IL2232-HT2022-HIL/HARDWARE_DEV/README.md

# HARDWARE_DEV
Hardware development for the project
