IL2232-HT2022-HIL/HARDWARE_DEV/ADAPTER_BOARD/GERBERS/V1/JLCPCB/BOM_V1.csv

Comment | Designator | Footprint | LCSC Part Number
100nF 25V | C1 C2 | C_0603_1608Metric | C14663
1kR | R1 R2 R3 R4 R5 R6 R7 R8 R9 R10 R11 R12 R13 | R_0603_1608Metric | C21190
10kR | R14 R15 | R_0603_1608Metric | C25804
120R | R21 R22 | R_0603_1608Metric | C22787
3k3 | R16 | R_0603_1608Metric | C22978
general-purpose | D1 D2 | D_SOD-323 | C60580
SN65HVD233 | U1 U2 | SOIC-8_3.9x4.9mm_P1.27mm | C61643
