IL2232-HT2022-HIL/HARDWARE_DEV/ADAPTER_BOARD/SCHEMATICS/HIL_ADAPTER_BOARD_V1.pdf

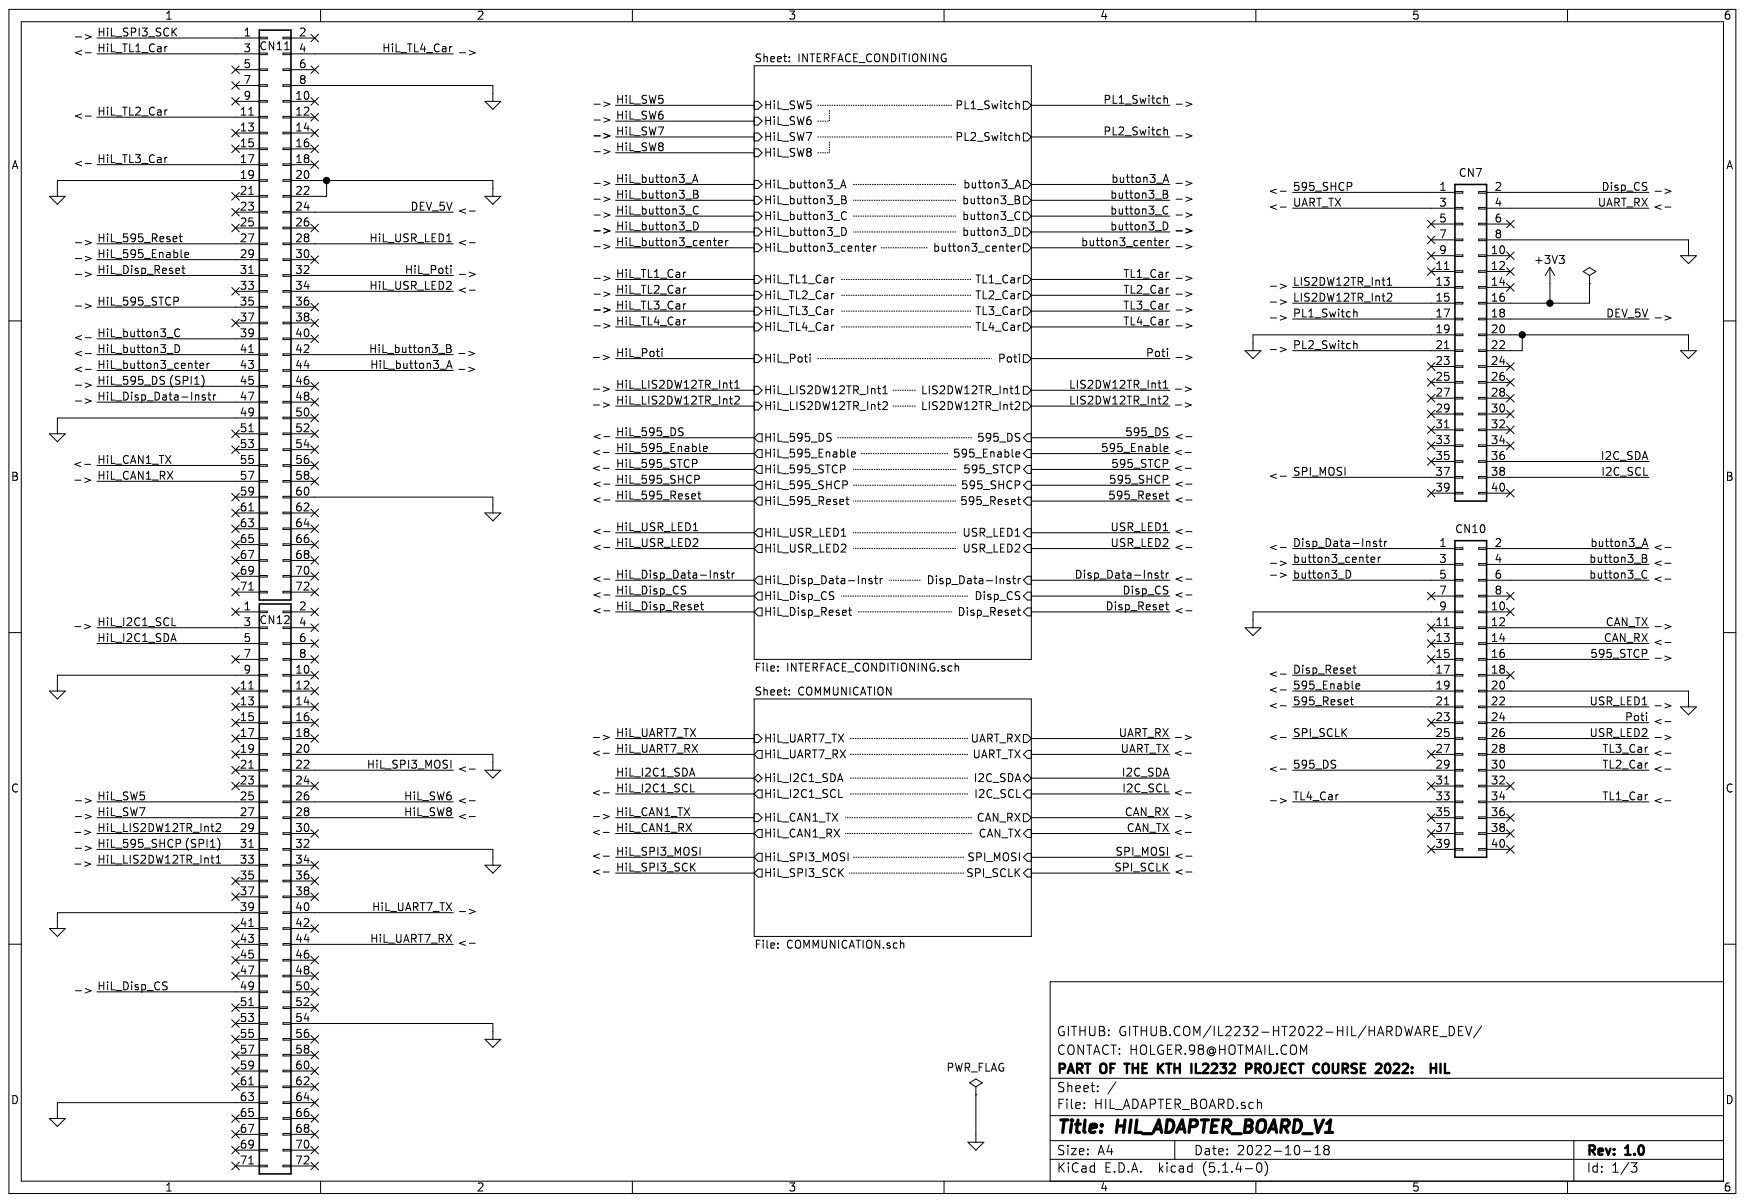
[picture p1: page 1]

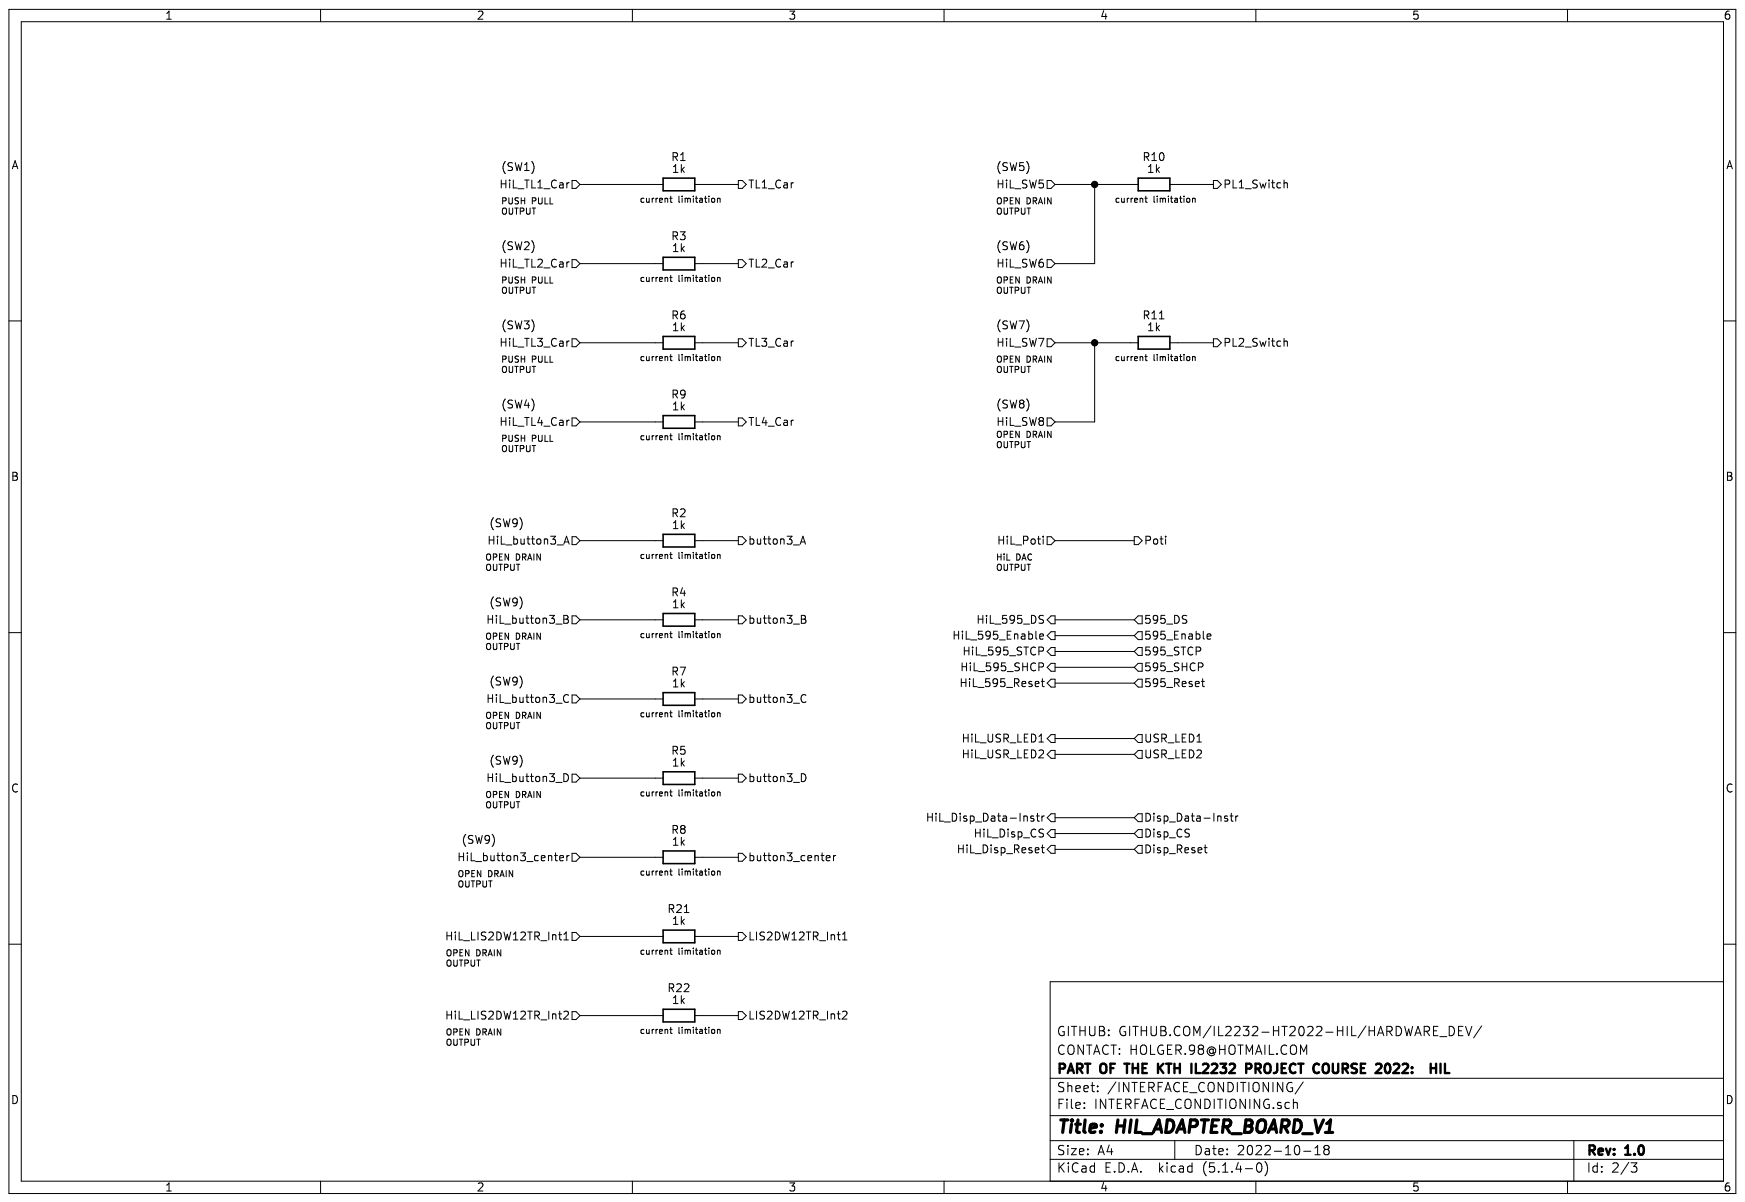
[picture p2: page 2]

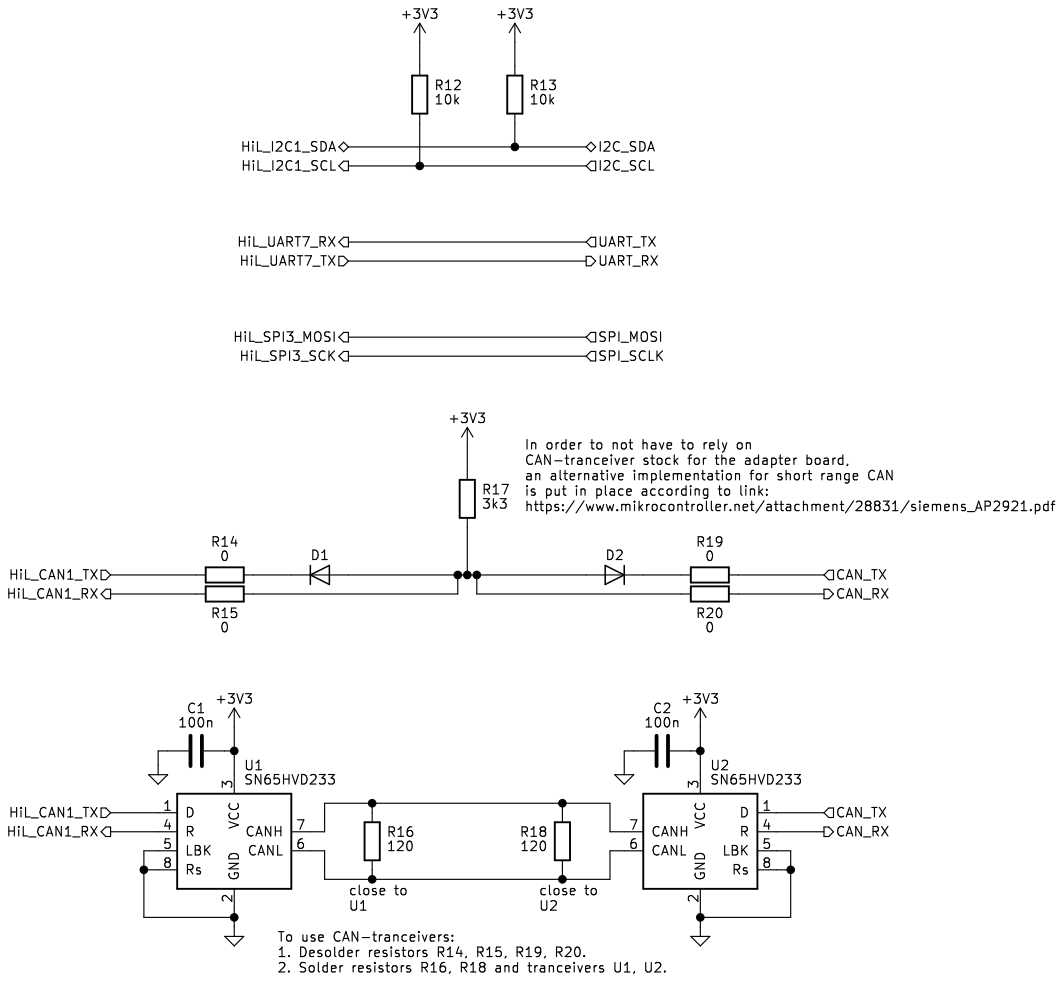
[picture p3: page 3]
