IL2232-HT2022-HIL/HARDWARE_DEV/ADAPTER_BOARD/HIL_ADAPTER_BOARD_V1/HIL_ADAPTER_BOARD.kicad_pcb

## KiCad design ADAPTER_BOARD/HIL_ADAPTER_BOARD_V1/HIL_ADAPTER_BOARD.kicad_pcb (2022-11-03)

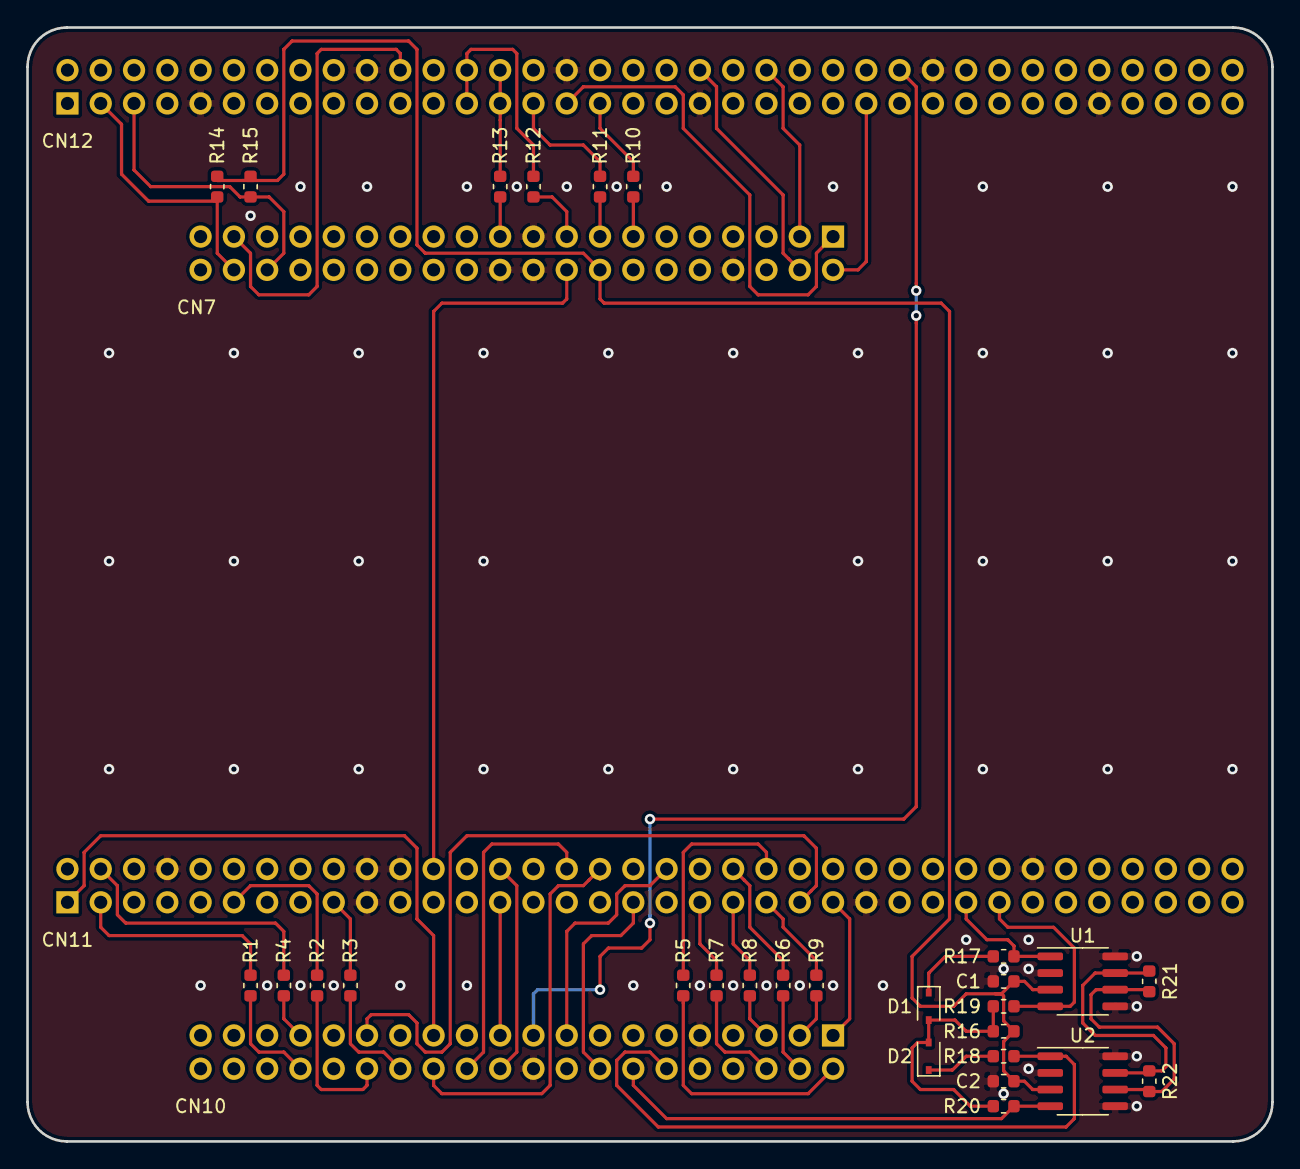
[picture p4: board HIL_ADAPTER_BOARD.kicad_pcb from above]

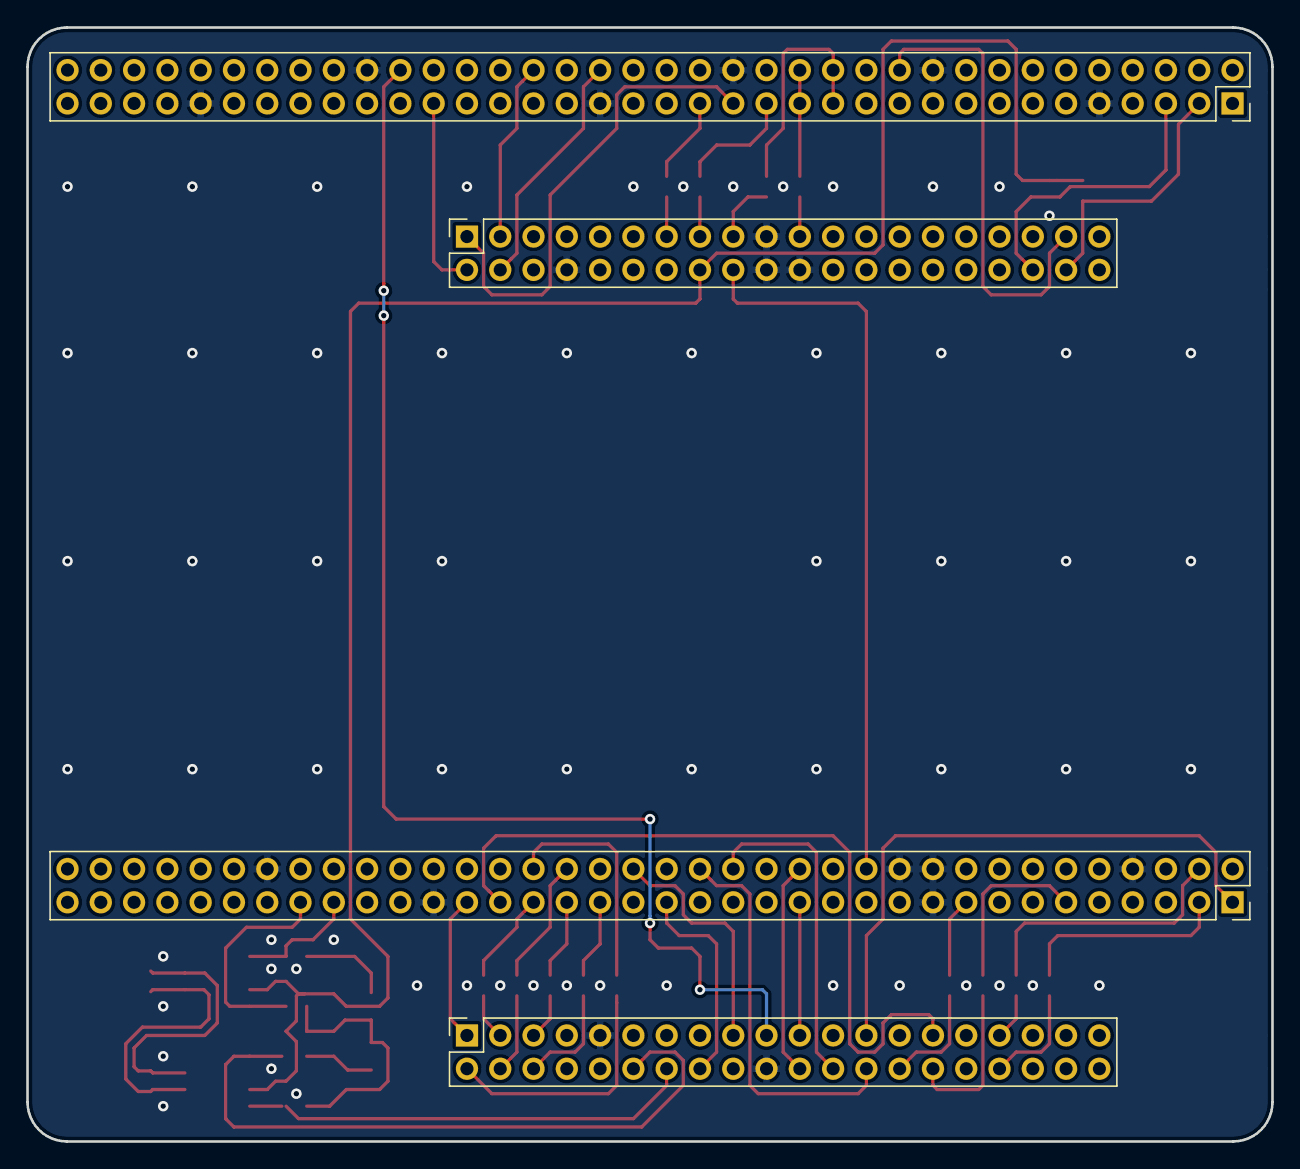
[picture p5: board HIL_ADAPTER_BOARD.kicad_pcb from below]

Board: 2 copper layers, 95.0 x 85.0 mm, 32 parts (4 on the bottom side), 55 nets.

Parts:
C1, C2: 100n; C_0603_1608Metric
CN7, CN10: Conn_02x20_Odd_Even; PinSocket_2x20_P2.54mm_Vertical
CN11, CN12: Conn_02x36_Odd_Even; PinSocket_2x36_P2.54mm_Vertical
D1, D2: D; D_SOD-323
R1, R2, R3, R4, R5, R6, R7, R8, R9, R10, R11, R12, R13: 1k; R_0603_1608Metric
R14, R15: 10k; R_0603_1608Metric
R16: 3k3; R_0603_1608Metric
R17, R18, R19, R20: 0; R_0603_1608Metric
R21, R22: 120; R_0603_1608Metric
U1, U2: SN65HVD233; SOIC-8_3.9x4.9mm_P1.27mm

Connections:
+3V3: C1.1, C2.1, CN7.16, R14.1, R15.1, R16.1, U1.3, U2.3
/595_DS: CN10.29, CN11.45
/595_Enable: CN10.19, CN12.52
/595_Reset: CN10.21, CN11.27
/595_SHCP: CN7.1, CN12.31
/595_STCP: CN10.16, CN11.35
/CAN_RX: CN10.14, R20.1, U2.4
/CAN_TX: CN10.12, R18.1, U2.1
/DEV_5V: CN7.18, CN11.24
/Disp_CS: CN7.2, CN12.49
/Disp_Data-Instr: CN10.1, CN11.47
/Disp_Reset: CN10.17, CN11.38
/HiL_CAN1_RX: CN11.57, R19.2, U1.4
/HiL_CAN1_TX: CN11.55, R17.2, U1.1
/HiL_I2C1_SCL: CN7.38, CN12.3, R14.2
/HiL_I2C1_SDA: CN7.36, CN12.5, R15.2
/HiL_LIS2DW12TR_Int1: CN12.33, R10.2
/HiL_LIS2DW12TR_Int2: CN12.29, R11.2
/HiL_Poti: CN10.24, CN11.32
/HiL_SPI3_MOSI: CN7.37, CN12.22
/HiL_SPI3_SCK: CN10.25, CN11.1
/HiL_SW5: CN12.25, CN12.26, R12.2
/HiL_SW7: CN12.27, CN12.28, R13.2
/HiL_TL1_Car: CN11.3, R1.2
/HiL_TL2_Car: CN11.11, R2.2
/HiL_TL3_Car: CN11.17, R3.2
/HiL_TL4_Car: CN11.4, R4.2
/HiL_UART7_RX: CN7.3, CN12.44
/HiL_UART7_TX: CN7.4, CN12.40
/HiL_USR_LED1: CN10.22, CN11.28
/HiL_USR_LED2: CN10.26, CN11.34
/HiL_button3_A: CN11.44, R5.2
/HiL_button3_B: CN11.42, R6.2
/HiL_button3_C: CN11.39, R7.2
/HiL_button3_D: CN11.41, R8.2
/HiL_button3_center: CN11.43, R9.2
/LIS2DW12TR_Int1: CN7.13, R10.1
/LIS2DW12TR_Int2: CN7.15, R11.1
/PL1_Switch: CN7.17, R12.1
/PL2_Switch: CN7.21, R13.1
/TL1_Car: CN10.34, R1.1
/TL2_Car: CN10.30, R2.1
/TL3_Car: CN10.28, R3.1
/TL4_Car: CN10.33, R4.1
/button3_A: CN10.2, R5.1
/button3_B: CN10.4, R6.1
/button3_C: CN10.6, R7.1
/button3_D: CN10.5, R8.1
/button3_center: CN10.3, R9.1
GND: C1.2, C2.2, CN7.8, CN7.19, CN7.20, CN7.22, CN10.9, CN10.20, CN11.8, CN11.19, CN11.20, CN11.22, CN11.49, CN11.60, CN12.9, CN12.20, CN12.32, CN12.39, CN12.54, CN12.63, U1.2, U1.5, U1.8, U2.2, U2.5, U2.8
unnamed: D1.1, R17.1
unnamed: D1.2, D2.2, R16.2, R19.1, R20.2
unnamed: D2.1, R18.2
unnamed: R21.1, R22.1, U1.7, U2.7
unnamed: R21.2, R22.2, U1.6, U2.6
