IL2232-HT2022-HIL/HARDWARE_DEV/(threads)

Thread 1 (2022-09-15):

Setup Kicad with the HARDWARE_DEV repo

HolgerStenberg, 2022-09-15:
I think that Kicad should be used as the ECAD tool for developing the adapter PCB described in the project proposal.
I will therefore setup a kicad 5.0 project in this repo

HolgerStenberg, 2022-09-15:
I think that Kicad should be used as the ECAD tool for developing the adapter PCB described in the project proposal.
I will therefore setup a kicad 5.0 project in this repo

Closed 2022-09-16.

Thread 3 (2022-09-15):

Aquire and familiarize with hardware boards

HolgerStenberg, 2022-09-15:
Find out about, install development environment.

HolgerStenberg, 2022-09-15:
There are two boards that will be part of the project:
- The MCU Development Board: Nucleo-L476RG
- The MCU HiL Board : Nucleo-F767ZI

I will investigate if these boards can be found as CAD-files

HolgerStenberg, 2022-09-16:
Additional information from mattias regarding what signals that are of interest is required to continue

HolgerStenberg, 2022-09-19:
MII or RMII ehternet interface?
- [ ] Solved?

sofiecmf, 2022-09-19:
We need for sure that these peripherals exists and do not collide with anything else :

1 USART bus
1 I2C bus
1 SPI bus
Ethernet (RMII or MII)
DAC for HiL (for potentiometer emulator)
ADC for Development MCU (for potentiometer read)

HolgerStenberg, 2022-09-19:
We are thinking of combining the power from both pcbs with only one usb cable (for ease-of-use).
Currently looking into how to configure the boards such that the MCU Development Board can power the adapter board and the HiL Board

HolgerStenberg, 2022-09-19:
On small board:
dis-connect JP1 for 300 mA over ST-link

Closed 2022-09-27.

Thread 4 (2022-09-15):

Work out the requirements for adapter PCB

HolgerStenberg, 2022-09-15:

HolgerStenberg, 2022-09-19:
We need for sure that:
* One usart bus needed
* 1 I2C BUS
* SPI BUS

HolgerStenberg, 2022-09-20:
We have gotten the schematic for the I/O board that we need to emulate

[Schematic_IS1300_2022_2022-04-19.pdf](https://github.com/IL2232-HT2022-HIL/HARDWARE_DEV/files/9607655/Schematic_IS1300_2022_2022-04-19.pdf)

HolgerStenberg, 2022-09-30:
Too broad issue for sprint. Is now divided into smaller sub-tasks in sprint 2

Closed 2022-10-18.

Thread 6 (2022-09-22):

Source and solder on X3 crystal oscillator on HiL-board

olleblo, 2022-09-22:
First investigate if HSI oscillator (16 MHZ ) on  board is enough and is usable.
In order to get intra-IC connectivity for ethernet communication to work properly and reliably, Holger states that we need to solder on a missing crystal oscillator (X3 on the PCB). See picture below for placement.

DONE CRITERIAS:
- [ ] When the correct crystal is soldered on.
- [ ] Jumper SB148 and SB163 OFF (Underside)
- [ ] SB8 and SB9 soldered
- [ ] C37 and C38 soldered with 4.3 pF capacitors. Footprint: 0603
- [ ] SB112 and SB149 OFF (Underside)
- [ ] Function has been verified

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

olleblo, 2022-09-30:
HSI Oscillator is based on RC oscillator which has at best 1% frequency stability compared to around 30 ppm for crystal oscillator. We deem it necessary then.

olleblo, 2022-09-30:
EVOLVE UPDATE: Sourcing took time and we*re waiting for delivery . We will solder it once it arrives.

Closed 2022-11-11.

Thread 10 (2022-09-30):

PCB: Choose appropriate IO for HiL pins with less constraints (GPIO)

HolgerStenberg, 2022-09-30:
In order to get a optimal routing for the adapter board, "repining"  of the HiL board shall be conducted in a way that don't require signals to travel far on the board. When a repinning that is considered good enought, this task is completed.

HolgerStenberg, 2022-10-03:
@matthiasthomasbecker are there any requirements on the pins for the following components in your shield that we need to emulate?
74HC595D - shift register
OLED Display

If the answer is no I will try to route the adapter board with these pins as generic GPIO pins.

/Holger

matthiasthomasbecker, 2022-10-03:
Hi Holger,

they have pre-defined pins. They are shown in the schematics (OLED on page 1 and the shift register on page 3). Let me know if you want to discuss earlier than the next meeting.

Best,
Matthias

matthiasthomasbecker, 2022-10-03:
ah now I understand :)
in both cases there can be SPI involved. For the shift register its more simple than for the display.
I have them on two different SPI interfaces.
There should be the possibility to use them with SPI as well (not necessarily included in the project but the adapter should allow it).
This is the configuration for the Nucleo_L476RG with the shield attached.
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

HolgerStenberg, 2022-10-03:
Allright! I will try configuring them with SPI. I will reach out If there are any problems!

/Holger

HolgerStenberg, 2022-10-04:
Hello again @matthiasthomasbecker!

Could you just verify that I'm thinking correctly regarding the shift register pinning:

595-SHCP: Should be connected to a SPI SCK  pin
595-STCP: Can be connected to any available pin
595-DS: Should be connected to a SPI MOSI pin
595-Enable: You connected a timer to this pin, but I guess it can be connected to a generic pin?
595-Reset: Can be connected to any available pin

matthiasthomasbecker, 2022-10-05:
Hi,
I also had a look and agree with almost all of the mapping.

For the 595-Enable pin, it would be great if it could connect to a timer pin (of an otherwise unused timer) on the HIL-Board as well.
That we have the possibility to measure the PWM signal (if it is used by the system under test) to see which brightness level the LEDs are at a specific time (I would say out of scope of the project work, or nice to have).

HolgerStenberg, 2022-10-14:
Hello @matthiasthomasbecker. Here is a Friday sneak-peak of the finalised schematics. I perform some extra verification steps in order to call the circuit complete! Soon this is done! :)

[ADAPTER_BOARD_SCHEMATICS_1.0.pdf](https://github.com/IL2232-HT2022-HIL/HARDWARE_DEV/files/9786981/ADAPTER_BOARD_SCHEMATICS_1.0.pdf)

Closed 2022-10-18.

Thread 12 (2022-09-30):

PCB: Finalise the board geometry

HolgerStenberg, 2022-09-30:
Once the pin selection is done, any geometry changes to the board shall be conducted before we try to route and populate the board.

Closed 2022-10-18.

Thread 13 (2022-09-30):

PCB: have the initial component layout done

HolgerStenberg, 2022-09-30:
At this point, it should be possible to start populate the board with resistors and other components that are required on the adapter PCB. When the population of all components are done, this issue is considered finished

Closed 2022-10-18.

Thread 7 (2022-09-30):

Source and solder on X3 crystal oscillator on HiL-board

olleblo, 2022-09-30:
First investigate if HSI oscillator (16 MHZ ) on  board is enough and is usable.
In order to get intra-IC connectivity for ethernet communication to work properly and reliably, Holger states that we need to solder on a missing crystal oscillator (X3 on the PCB). See picture below for placement.

DONE CRITERIAS:
- [ ] When the correct crystal is soldered on.
- [ ] Jumper SB148 and SB163 OFF (Underside)
- [ ] SB8 and SB9 soldered
- [ ] C37 and C38 soldered with 4.3 pF capacitors. Footprint: 0603
- [ ] SB112 and SB149 OFF (Underside)
- [ ] Function has been verified

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

HolgerStenberg, 2022-09-30:
paused due to order being made by @matthiasthomasbecker

HolgerStenberg, 2022-09-30:
@matthiasthomasbecker Will you also source the pin headers needed for the adapter PCB?
It should be 2x of the HiL-morpho connectors and 2x of the MCU-morpho connectors, with the other gender of course.

matthiasthomasbecker, 2022-10-04:
yes, I will provide those. I think we should have them in our local stock

matthiasthomasbecker, 2022-10-17:
Hi @HolgerStenberg , the components arrived now. If one of you is in Kista you can collect them.
Please let me know in advance to make sure that I am there as well when you want to collect them.

HolgerStenberg, 2022-10-18:
Perfect! We will make sure someone from our team gets them from Kista. This is probably a good task for @Fkar97 !

Fkar97, 2022-10-20:
@matthiasthomasbecker I'll be in Kista tomorrow, when would be a good time?

Closed 2022-11-11.

Thread 16 (2022-10-20):

Send the adapter board for production

HolgerStenberg, 2022-10-20:
Once the board has been reviewed by matthias, it can be ordered from JLC PCB. The required files for ordering can be found under "/ADAPTER_BOARD/GERBERS/V1". Only request from project group is that the PCB will be black, should not affect cost.

HolgerStenberg, 2022-10-20:
Give me one second to fix an issue regarding the ordering. We need to verify that certain functions work on the HiL board first (may be conflicts)

HolgerStenberg, 2022-11-11:
@matthiasthomasbecker Is this completed?

matthiasthomasbecker, 2022-11-11:
Hi Holger,

No this is not completed.
I am still waiting for the updated BOM files to work with JLCPCB.

The current version does not work with their page.

Could you please send me an updated version by email once done?

Best,
Matthias

From: Holger Stenberg ***@***.***>
Reply to: IL2232-HT2022-HIL/HARDWARE_DEV ***@***.***>
Date: Friday, 11 November 2022 at 11:52
To: IL2232-HT2022-HIL/HARDWARE_DEV ***@***.***>
Cc: Matthias Becker ***@***.***>, Mention ***@***.***>
Subject: Re: [IL2232-HT2022-HIL/HARDWARE_DEV] Send the adapter board for production (Issue #16)

@matthiasthomasbecker<https://github.com/matthiasthomasbecker> Is this completed?

—
Reply to this email directly, view it on GitHub<https://github.com/IL2232-HT2022-HIL/HARDWARE_DEV/issues/16#issuecomment-1311541512>, or unsubscribe<https://github.com/notifications/unsubscribe-auth/APIOFKYV3XZJYIMXXRKETATWHYQQJANCNFSM6AAAAAARKFINIY>.
You are receiving this because you were mentioned.Message ID: ***@***.***>

HolgerStenberg, 2022-11-11:
Certainly! I will try to get it done today. 👍

Closed 2022-12-15.

Thread 17 (2022-11-14):

fix the board bom parsing issue

HolgerStenberg, 2022-11-14:
As it seems, the bom are not complying with the parser settings of the JLCPCB website. This will be investigated during monday and be resolved as soon as possible in order for Matthias to order the pcbs

HolgerStenberg, 2022-11-15:
The JLCPCB csv format don't handle semicolons, therefore the parsing of the files failed before

Closed 2022-11-15.

Thread 18 (2022-11-28):

Project management: write status report 2

sofiecmf, 2022-11-28:
In this course, two status reports are mandatory to hand in. This will be the second one of the two status reports and its due date is on Monday the 5th of December at 23:59.

The status report should follow up on aspects from the project plan that are completed, and on any changes made. The risk report should be revisited and the time and resource plan updated.

Link to document:
https://www.overleaf.com/3487978118zczxynmjdsxz

To do:

- [x] create skeleton document in overleaf

- [x] partition the workload

- [x] inform team-mates on what parts need work

- [ ] upload first draft to github for matthias to review

- [ ] address any comments on updates

- [ ] hand in on canvas

sofiecmf, 2022-11-30:
Hi team,

I have created a document for status report 2 and made some comments where information needs to be added. These are the parts where I need your assistance in writing:

- [ ] Update progress on deliverable D2
- [ ] Update progress on deliverable D3 (@olleblo?)
- [ ] Update progress on deliverable D5
- [ ] Write about what has been done in relation to the resource plan and deliverables
- [ ] Write about a challenge (if there is one)
- [ ] Write about any alterations made to the project in relation to the project plan (if there is one)

Please also update your hours in the resource document on google drive! :)

These are the parts I have assigned for myself to write, but if you want to add something to these parts just go ahead:

- [ ] Write current status
- [ ] Update progress on deliverable D1
- [ ] Update progress on deliverable D4
- [ ] Write about hours worked and hours budgeted
- [ ] Summarize the issue with SPI
- [ ] Update Gantt chart
- [ ] Update Resource plan

sofiecmf, 2022-12-04:
Questions:

What is deliverable D4.6, and have we made any progress on this?

HolgerStenberg, 2022-12-04:
Will update tomorrow! @sofiecmf Could you assign me to some parts?

sofiecmf, 2022-12-04:
Cool, thank you @HolgerStenberg ! Could you write some words on our progress of deliverables D2 and D5? I think you have knowledge of this :)

HolgerStenberg, 2022-12-05:
@sofiecmf I think my parts are good to go now 👍

Yuxiaowa, 2022-12-05:
Hi everyone,
I have managed to fill in the worked time of mine, and I also added my parts in Current status description of status report 2.
I cannot think of any challenges in the third chapter.
If there is anything else that I need to add or modify, please let me know ;)

Closed 2022-12-15.
