IL2232-HT2022-HIL/HARDWARE_DEV/(commit log)

2022-09-15 created an empty project for the adapter board
    see commit name
    [KTH_HIL-adapter_board_1.0.kicad_pcb, KTH_HIL-adapter_board_1.0.sch]
2022-09-15 push new resistor (#2)
    [KTH_HIL-adapter_board_1.0.sch]
2022-11-03 Merge v1 of adapter board to main (#15)
    * v1 is final
    * cleaned up the branch a bit
    * Had to reconfigure 2 pins due to collision
    * fixed timer issue in routing
    * fixed timer issue
    * Fixed comments regarding schematic
    * added manufacturing files
    [BOM_V1.csv, COMMUNICATION.sch, HIL_ADAPTER_BOARD.kicad_pcb, HIL_ADAPTER_BOARD.sch, INTERFACE_CONDITIONING.sch, KTH_HIL-adapter_board_1.0.kicad_pcb, KTH_HIL-adapter_board_1.0.sch, POS_V1.csv]
2022-11-15 fixed BOM and POS issue
    JLCPCB parsing is done with commas and not semicolons. Issue now fixed
    [BOM_V1.csv, POS_V1.csv]
